vuloi05/he_nhung_remote/Core/Src/main.c

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
/* Includes ------------------------------------------------------------------*/
#include "main.h"
#include "cmsis_os.h"
#include "adc.h"
#include "crc.h"
#include "dma.h"
#include "dma2d.h"
#include "i2c.h"
#include "ltdc.h"
#include "spi.h"
#include "usb_device.h"
#include "gpio.h"
#include "fmc.h"
#include "app_touchgfx.h"

/* USER CODE BEGIN Includes */
#include "Components/ili9341/ili9341.h"
#include "input_manager.h"
/* USER CODE END Includes */

/* USER CODE BEGIN PD */
#define REFRESH_COUNT           ((uint32_t)1386)   /* SDRAM refresh counter */
#define SDRAM_TIMEOUT           ((uint32_t)0xFFFF)

/**
  * @brief  FMC SDRAM Mode definition register defines
  */
#define SDRAM_MODEREG_BURST_LENGTH_1             ((uint16_t)0x0000)
#define SDRAM_MODEREG_BURST_LENGTH_2             ((uint16_t)0x0001)
#define SDRAM_MODEREG_BURST_LENGTH_4             ((uint16_t)0x0002)
#define SDRAM_MODEREG_BURST_LENGTH_8             ((uint16_t)0x0004)
#define SDRAM_MODEREG_BURST_TYPE_SEQUENTIAL      ((uint16_t)0x0000)
#define SDRAM_MODEREG_BURST_TYPE_INTERLEAVED     ((uint16_t)0x0008)
#define SDRAM_MODEREG_CAS_LATENCY_2              ((uint16_t)0x0020)
#define SDRAM_MODEREG_CAS_LATENCY_3              ((uint16_t)0x0030)
#define SDRAM_MODEREG_OPERATING_MODE_STANDARD    ((uint16_t)0x0000)
#define SDRAM_MODEREG_WRITEBURST_MODE_PROGRAMMED ((uint16_t)0x0000)
#define SDRAM_MODEREG_WRITEBURST_MODE_SINGLE     ((uint16_t)0x0200)

#define I2C3_TIMEOUT_MAX                    0x3000 /*<! The value of the maximal timeout for I2C waiting loops */
#define SPI5_TIMEOUT_MAX                    0x1000
/* USER CODE END PD */


/* USER CODE BEGIN PV */
uint8_t isRevD = 0; /* Applicable only for STM32F429I DISCOVERY REVD and above */
/* USER CODE END PV */

void SystemClock_Config(void);
void MX_FREERTOS_Init(void);
/* USER CODE BEGIN PFP */
static void BSP_SDRAM_Initialization_Sequence(SDRAM_HandleTypeDef *hsdram, FMC_SDRAM_CommandTypeDef *Command);



static uint8_t            I2C3_ReadData(uint8_t Addr, uint8_t Reg);
static void               I2C3_WriteData(uint8_t Addr, uint8_t Reg, uint8_t Value);
static uint8_t            I2C3_ReadBuffer(uint8_t Addr, uint8_t Reg, uint8_t *pBuffer, uint16_t Length);

/* SPIx bus function */
static void               SPI5_Write(uint16_t Value);
static uint32_t           SPI5_Read(uint8_t ReadSize);
static void               SPI5_Error(void);

/* Link function for LCD peripheral */
void                      LCD_IO_Init(void);
void                      LCD_IO_WriteData(uint16_t RegValue);
void                      LCD_IO_WriteReg(uint8_t Reg);
uint32_t                  LCD_IO_ReadData(uint16_t RegValue, uint8_t ReadSize);
void                      LCD_Delay(uint32_t delay);

/* IOExpander IO functions */
void                      IOE_Init(void);
void                      IOE_ITConfig(void);
void                      IOE_Delay(uint32_t Delay);
void                      IOE_Write(uint8_t Addr, uint8_t Reg, uint8_t Value);
uint8_t                   IOE_Read(uint8_t Addr, uint8_t Reg);
uint16_t                  IOE_ReadMultiple(uint8_t Addr, uint8_t Reg, uint8_t *pBuffer, uint16_t Length);

/* USER CODE END PFP */

/* USER CODE BEGIN 0 */
static LCD_DrvTypeDef* LcdDrv;

uint32_t I2c3Timeout = I2C3_TIMEOUT_MAX; /*<! Value of Timeout when I2C communication fails */
uint32_t Spi5Timeout = SPI5_TIMEOUT_MAX; /*<! Value of Timeout when SPI communication fails */
/* USER CODE END 0 */

/**
  * @brief  The application entry point.
  * @retval int
  */
int main(void)
{

  /* MCU Configuration--------------------------------------------------------*/

  /* Reset of all peripherals, Initializes the Flash interface and the Systick. */
  HAL_Init();

  /* Configure the system clock */
  SystemClock_Config();

  /* Initialize all configured peripherals */
  MX_GPIO_Init();
  MX_DMA_Init();
  MX_CRC_Init();
  MX_I2C3_Init();
  MX_SPI5_Init();
  MX_FMC_Init();
  MX_LTDC_Init();
  MX_DMA2D_Init();
  MX_ADC1_Init();
  MX_ADC3_Init();
  MX_TouchGFX_Init();
  /* Call PreOsInit function */
  MX_TouchGFX_PreOSInit();
  /* USER CODE BEGIN 2 */
  // 1. Đánh thức và cấu hình chip màn hình ILI9341
  ili9341_Init();

  // 2. Gửi chuỗi lệnh kích hoạt RAM ngoài (SDRAM) để TouchGFX có chỗ vẽ UI
  FMC_SDRAM_CommandTypeDef command;
  BSP_SDRAM_Initialization_Sequence(&hsdram1, &command);

  /* USER CODE END 2 */

  /* Init scheduler */
  osKernelInitialize();  /* Call init function for freertos objects (in cmsis_os2.c) */
  MX_FREERTOS_Init();

  /* Start scheduler */
  osKernelStart();

  /* We should never get here as control is now taken by the scheduler */

  /* Infinite loop */
  /* USER CODE BEGIN WHILE */
  while (1)
  {
    /* USER CODE END WHILE */

    /* USER CODE BEGIN 3 */
  }
  /* USER CODE END 3 */
}

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
/* USER CODE BEGIN 4 */
/**
  * @brief  Perform the SDRAM external memory initialization sequence
  * @param  hsdram: SDRAM handle
  * @param  Command: Pointer to SDRAM command structure
  * @retval None
  */
static void BSP_SDRAM_Initialization_Sequence(SDRAM_HandleTypeDef *hsdram, FMC_SDRAM_CommandTypeDef *Command)
{
 __IO uint32_t tmpmrd =0;

  /* Step 1:  Configure a clock configuration enable command */
  Command->CommandMode             = FMC_SDRAM_CMD_CLK_ENABLE;
  Command->CommandTarget           = FMC_SDRAM_CMD_TARGET_BANK2;
  Command->AutoRefreshNumber       = 1;
  Command->ModeRegisterDefinition  = 0;

  /* Send the command */
  HAL_SDRAM_SendCommand(hsdram, Command, SDRAM_TIMEOUT);

  /* Step 2: Insert 100 us minimum delay */
  /* Inserted delay is equal to 1 ms due to systick time base unit (ms) */
  HAL_Delay(1);

  /* Step 3: Configure a PALL (precharge all) command */
  Command->CommandMode             = FMC_SDRAM_CMD_PALL;
  Command->CommandTarget           = FMC_SDRAM_CMD_TARGET_BANK2;
  Command->AutoRefreshNumber       = 1;
  Command->ModeRegisterDefinition  = 0;

  /* Send the command */
  HAL_SDRAM_SendCommand(hsdram, Command, SDRAM_TIMEOUT);

  /* Step 4: Configure an Auto Refresh command */
  Command->CommandMode             = FMC_SDRAM_CMD_AUTOREFRESH_MODE;
  Command->CommandTarget           = FMC_SDRAM_CMD_TARGET_BANK2;
  Command->AutoRefreshNumber       = 4;
  Command->ModeRegisterDefinition  = 0;

  /* Send the command */
  HAL_SDRAM_SendCommand(hsdram, Command, SDRAM_TIMEOUT);

  /* Step 5: Program the external memory mode register */
  tmpmrd = (uint32_t)SDRAM_MODEREG_BURST_LENGTH_1          |
                     SDRAM_MODEREG_BURST_TYPE_SEQUENTIAL   |
                     SDRAM_MODEREG_CAS_LATENCY_3           |
                     SDRAM_MODEREG_OPERATING_MODE_STANDARD |
                     SDRAM_MODEREG_WRITEBURST_MODE_SINGLE;

  Command->CommandMode             = FMC_SDRAM_CMD_LOAD_MODE;
  Command->CommandTarget           = FMC_SDRAM_CMD_TARGET_BANK2;
  Command->AutoRefreshNumber       = 1;
  Command->ModeRegisterDefinition  = tmpmrd;

  /* Send the command */
  HAL_SDRAM_SendCommand(hsdram, Command, SDRAM_TIMEOUT);

  /* Step 6: Set the refresh rate counter */
  /* Set the device refresh rate */
  HAL_SDRAM_ProgramRefreshRate(hsdram, REFRESH_COUNT);
}

/**
  * @brief  IOE Low Level Initialization.
  */
void IOE_Init(void)
{
  //Dummy function called when initializing to stmpe811 to setup the i2c.
  //This is done with cubmx and is therfore not done here.
}

/**
  * @brief  IOE Low Level Interrupt configuration.
  */
void IOE_ITConfig(void)
{
  //Dummy function called when initializing to stmpe811 to setup interupt for the i2c.
  //The interupt is not used in our case, therefore nothing is done here.
}

/**
  * @brief  IOE Writes single data operation.
  * @param  Addr: I2C Address
  * @param  Reg: Reg Address
  * @param  Value: Data to be written
  */
void IOE_Write(uint8_t Addr, uint8_t Reg, uint8_t Value)
{
  I2C3_WriteData(Addr, Reg, Value);
}

/**
  * @brief  IOE Reads single data.
  * @param  Addr: I2C Address
  * @param  Reg: Reg Address
  * @retval The read data
  */
uint8_t IOE_Read(uint8_t Addr, uint8_t Reg)
{
  return I2C3_ReadData(Addr, Reg);
}

/**
  * @brief  IOE Reads multiple data.
  * @param  Addr: I2C Address
  * @param  Reg: Reg Address
  * @param  pBuffer: pointer to data buffer
  * @param  Length: length of the data
  * @retval 0 if no problems to read multiple data
  */
uint16_t IOE_ReadMultiple(uint8_t Addr, uint8_t Reg, uint8_t *pBuffer, uint16_t Length)
{
 return I2C3_ReadBuffer(Addr, Reg, pBuffer, Length);
}

/**
  * @brief  IOE Delay.
  * @param  Delay in ms
  */
void IOE_Delay(uint32_t Delay)
{
  HAL_Delay(Delay);
}

/**
  * @brief  Writes a value in a register of the device through BUS.
  * @param  Addr: Device address on BUS Bus.
  * @param  Reg: The target register address to write
  * @param  Value: The target register value to be written
  */
static void I2C3_WriteData(uint8_t Addr, uint8_t Reg, uint8_t Value)
{
  HAL_StatusTypeDef status = HAL_OK;

  status = HAL_I2C_Mem_Write(&hi2c3, Addr, (uint16_t)Reg, I2C_MEMADD_SIZE_8BIT, &Value, 1, I2c3Timeout);

  /* Check the communication status */
  if(status != HAL_OK)
  {
    /* Re-Initialize the BUS */
    //I2Cx_Error();
  }
}

/**
  * @brief  Reads a register of the device through BUS.
  * @param  Addr: Device address on BUS Bus.
  * @param  Reg: The target register address to write
  * @retval Data read at register address
  */
static uint8_t I2C3_ReadData(uint8_t Addr, uint8_t Reg)
{
  HAL_StatusTypeDef status = HAL_OK;
  uint8_t value = 0;

  status = HAL_I2C_Mem_Read(&hi2c3, Addr, Reg, I2C_MEMADD_SIZE_8BIT, &value, 1, I2c3Timeout);

  /* Check the communication status */
  if(status != HAL_OK)
  {
    /* Re-Initialize the BUS */
    //I2Cx_Error();

  }
  return value;
}

/**
  * @brief  Reads multiple data on the BUS.
  * @param  Addr: I2C Address
  * @param  Reg: Reg Address
  * @param  pBuffer: pointer to read data buffer
  * @param  Length: length of the data
  * @retval 0 if no problems to read multiple data
  */
static uint8_t I2C3_ReadBuffer(uint8_t Addr, uint8_t Reg, uint8_t *pBuffer, uint16_t Length)
{
  HAL_StatusTypeDef status = HAL_OK;

  status = HAL_I2C_Mem_Read(&hi2c3, Addr, (uint16_t)Reg, I2C_MEMADD_SIZE_8BIT, pBuffer, Length, I2c3Timeout);

  /* Check the communication status */
  if(status == HAL_OK)
  {
    return 0;
  }
  else
  {
    /* Re-Initialize the BUS */
    //I2Cx_Error();

    return 1;
  }
}

/**
  * @brief  Reads 4 bytes from device.
  * @param  ReadSize: Number of bytes to read (max 4 bytes)
  * @retval Value read on the SPI
  */
static uint32_t SPI5_Read(uint8_t ReadSize)
{
  HAL_StatusTypeDef status = HAL_OK;
  uint32_t readvalue;

  status = HAL_SPI_Receive(&hspi5, (uint8_t*) &readvalue, ReadSize, Spi5Timeout);

  /* Check the communication status */
  if(status != HAL_OK)
  {
    /* Re-Initialize the BUS */
    SPI5_Error();
  }

  return readvalue;
}

/**
  * @brief  Writes a byte to device.
  * @param  Value: value to be written
  */
static void SPI5_Write(uint16_t Value)
{
  HAL_StatusTypeDef status = HAL_OK;

  status = HAL_SPI_Transmit(&hspi5, (uint8_t*) &Value, 1, Spi5Timeout);

  /* Check the communication status */
  if(status != HAL_OK)
  {
    /* Re-Initialize the BUS */
    SPI5_Error();
  }
}

/**
  * @brief  SPI5 error treatment function.
  */
static void SPI5_Error(void)
{
  /* De-initialize the SPI communication BUS */
  //HAL_SPI_DeInit(&SpiHandle);

  /* Re- Initialize the SPI communication BUS */
  //SPIx_Init();
}

void LCD_IO_Init(void)
{
  /* Set or Reset the control line */
  HAL_GPIO_WritePin(GPIOC, GPIO_PIN_2, GPIO_PIN_RESET);
  HAL_GPIO_WritePin(GPIOC, GPIO_PIN_2, GPIO_PIN_SET);
}

/**
  * @brief  Writes register value.
  */
void LCD_IO_WriteData(uint16_t RegValue)
{
  /* Set WRX to send data */
  HAL_GPIO_WritePin(GPIOD, GPIO_PIN_13, GPIO_PIN_SET);

  /* Reset LCD control line(/CS) and Send data */
  HAL_GPIO_WritePin(GPIOC, GPIO_PIN_2, GPIO_PIN_RESET);
  SPI5_Write(RegValue);

  /* Deselect: Chip Select high */
  HAL_GPIO_WritePin(GPIOC, GPIO_PIN_2, GPIO_PIN_SET);
}

/**
  * @brief  Writes register address.
  */
void LCD_IO_WriteReg(uint8_t Reg)
{
  /* Reset WRX to send command */
  HAL_GPIO_WritePin(GPIOD, GPIO_PIN_13, GPIO_PIN_RESET);

  /* Reset LCD control line(/CS) and Send command */
  HAL_GPIO_WritePin(GPIOC, GPIO_PIN_2, GPIO_PIN_RESET);
  SPI5_Write(Reg);

  /* Deselect: Chip Select high */
  HAL_GPIO_WritePin(GPIOC, GPIO_PIN_2, GPIO_PIN_SET);
}

/**
  * @brief  Reads register value.
  * @param  RegValue Address of the register to read
  * @param  ReadSize Number of bytes to read
  * @retval Content of the register value
  */
uint32_t LCD_IO_ReadData(uint16_t RegValue, uint8_t ReadSize)
{
  uint32_t readvalue = 0;

  /* Select: Chip Select low */
  HAL_GPIO_WritePin(GPIOC, GPIO_PIN_2, GPIO_PIN_RESET);

  /* Reset WRX to send command */
  HAL_GPIO_WritePin(GPIOD, GPIO_PIN_13, GPIO_PIN_RESET);

  SPI5_Write(RegValue);

  readvalue = SPI5_Read(ReadSize);

  /* Set WRX to send data */
  HAL_GPIO_WritePin(GPIOD, GPIO_PIN_13, GPIO_PIN_SET);

  /* Deselect: Chip Select high */
  HAL_GPIO_WritePin(GPIOC, GPIO_PIN_2, GPIO_PIN_SET);

  return readvalue;
}

/**
  * @brief  Wait for loop in ms.
  * @param  Delay in ms.
  */
void LCD_Delay(uint32_t Delay)
{
  HAL_Delay(Delay);
}

void HAL_GPIO_EXTI_Callback(uint16_t GPIO_Pin)
{
    // Kích hoạt khi nhấn nút USER (Nối PA0)
    if(GPIO_Pin == USER_BTN_Pin)
    {
        // Kỹ thuật Debounce (Chống dội phím) đơn giản
        // Nếu nhấn quá sát nhau (dưới 200ms) thì bỏ qua
        static uint32_t last_time = 0;
        uint32_t current_time = HAL_GetTick();

        if (current_time - last_time > 200) {
            InputManager_ToggleMode();
            last_time = current_time;
        }
    }
}

/* USER CODE END 4 */

/**
  * @brief  Period elapsed callback in non blocking mode
  * @note   This function is called  when TIM6 interrupt took place, inside
  * HAL_TIM_IRQHandler(). It makes a direct call to HAL_IncTick() to increment
  * a global variable "uwTick" used as application time base.
  * @param  htim : TIM handle
  * @retval None
  */
void HAL_TIM_PeriodElapsedCallback(TIM_HandleTypeDef *htim)
{
  if (htim->Instance == TIM6)
  {
    HAL_IncTick();
  }
}

/**
  * @brief  This function is executed in case of error occurrence.
  * @retval None
  */
void Error_Handler(void)
{
  /* USER CODE BEGIN Error_Handler_Debug */
  /* User can add his own implementation to report the HAL error return state */

  /* USER CODE END Error_Handler_Debug */
}
#ifdef USE_FULL_ASSERT
/**
  * @brief  Reports the name of the source file and the source line number
  *         where the assert_param error has occurred.
  * @param  file: pointer to the source file name
  * @param  line: assert_param error line source number
  * @retval None
  */
void assert_failed(uint8_t *file, uint32_t line)
{
  /* USER CODE BEGIN 6 */
  /* User can add his own implementation to report the file name and line number,
     tex: printf("Wrong parameters value: file %s on line %d\r\n", file, line) */
  /* USER CODE END 6 */
}
#endif /* USE_FULL_ASSERT */
