vuloi05/he_nhung_remote/Core/Inc/main.h

#define VSYNC_FREQ_Pin GPIO_PIN_2
#define VSYNC_FREQ_GPIO_Port GPIOE
#define RENDER_TIME_Pin GPIO_PIN_3
#define RENDER_TIME_GPIO_Port GPIOE
#define FRAME_RATE_Pin GPIO_PIN_4
#define FRAME_RATE_GPIO_Port GPIOE
#define MCU_ACTIVE_Pin GPIO_PIN_5
#define MCU_ACTIVE_GPIO_Port GPIOE
#define SPI5_NCS_Pin GPIO_PIN_1
#define SPI5_NCS_GPIO_Port GPIOC
#define USER_BTN_Pin GPIO_PIN_0
#define USER_BTN_GPIO_Port GPIOA
#define USER_BTN_EXTI_IRQn EXTI0_IRQn
#define JOY_L_SW_Pin GPIO_PIN_2
#define JOY_L_SW_GPIO_Port GPIOB
#define BTN_L2_Pin GPIO_PIN_2
#define BTN_L2_GPIO_Port GPIOG
#define BTN_R2_Pin GPIO_PIN_3
#define BTN_R2_GPIO_Port GPIOG
#define BTN_CROSS_Pin GPIO_PIN_8
#define BTN_CROSS_GPIO_Port GPIOC
#define BTN_CIRCLE_Pin GPIO_PIN_9
#define BTN_CIRCLE_GPIO_Port GPIOA
#define BTN_SQUARE_Pin GPIO_PIN_10
#define BTN_SQUARE_GPIO_Port GPIOA
#define BTN_R1_Pin GPIO_PIN_2
#define BTN_R1_GPIO_Port GPIOD
#define LED_GREEN_Pin GPIO_PIN_13
#define LED_GREEN_GPIO_Port GPIOG
#define LED_RED_Pin GPIO_PIN_14
#define LED_RED_GPIO_Port GPIOG
#define BTN_TRIANGLE_Pin GPIO_PIN_3
#define BTN_TRIANGLE_GPIO_Port GPIOB
#define JOY_R_SW_Pin GPIO_PIN_4
#define JOY_R_SW_GPIO_Port GPIOB
#define BTN_L1_Pin GPIO_PIN_7
#define BTN_L1_GPIO_Port GPIOB
