vuloi05/he_nhung_remote/Core/Src/L3GD20.c

//----------------------------------------------------------------------------//
// This file is from https://github.com/adem-alnajjar/Gyroscope-L3GD20-_STM32 //
// and was modified by Cong Thuan Do (HUST) for STM32F429-DISC1 board         //
//----------------------------------------------------------------------------//

#include "main.h"
#include "L3GD20.h"

#define AVERAGE_WINDOW_SIZE                  ((uint32_t) 10u)
#define CALIBRATION_BUFFER_LENGTH            ((uint32_t) 2000u)
#define L3GD20_SENSITIVITY    ((float)0.07)
#define GYRO_LEAK_FACTOR 0.999f // 100Hz -> mất 50% tín hiệu sau 1.38s

extern SPI_HandleTypeDef hspi5;

typedef enum
{
	L3GD20_DATA_NOT_READY,
	L3GD20_DATA_READY,
}L3GD20_DataReadyFlagType;

static L3GD20_DataReadyFlagType dataReadyFlag=L3GD20_DATA_READY;

typedef enum
{
	L3GD20_collect_calibration_samples,
	L3GD20_process_calibration_samples,
	L3GD20_calibrated,
}L3GD20_caliStateType;

static L3GD20_caliStateType currentcalistate=L3GD20_collect_calibration_samples;



typedef enum
{
	L3GD20_fisrt,
	L3GD20_second,
	L3GD20_finaly
}L3GD20_StateType;
static L3GD20_StateType currentState=L3GD20_fisrt;
	

static float angleRate_x=0;
static float angleRate_y=0;
static float angleRate_z=0;

static int32_t offset_x=0;
static int32_t offset_y=0;
static int32_t offset_z=0;

static float Noise_X = 0;
static float Noise_Y = 0;
static float Noise_Z = 0;

static float Angle_X = 0;
static float Angle_Y = 0;
static float Angle_Z = 0;

static float LastAngleRate_X = 0;
static float LastAngleRate_Y = 0;
static float LastAngleRate_Z = 0;

static int32_t TempNoise_X = 0;
static int32_t TempNoise_Y = 0;
static int32_t TempNoise_Z = 0;


volatile static uint32_t caliCounter = 0;


static int16_t calibrationBuffer_X[CALIBRATION_BUFFER_LENGTH];
static int16_t calibrationBuffer_Y[CALIBRATION_BUFFER_LENGTH];
static int16_t calibrationBuffer_Z[CALIBRATION_BUFFER_LENGTH];

static uint8_t spiTxBuf[2];
static uint8_t spiRxBuf[7];

void L3GD20_Init(void)
{
	HAL_GPIO_WritePin(GPIOC,GPIO_PIN_1,GPIO_PIN_SET);
	HAL_Delay(20);
	
	HAL_GPIO_WritePin(GPIOC,GPIO_PIN_1,GPIO_PIN_RESET);
	HAL_Delay(20);
	spiTxBuf[0]=0x20;
	spiTxBuf[1]=0xff;
	HAL_SPI_Transmit(&hspi5,spiTxBuf,2,50);
	HAL_GPIO_WritePin(GPIOC,GPIO_PIN_1,GPIO_PIN_SET);
	HAL_Delay(20);
	
	HAL_GPIO_WritePin(GPIOC,GPIO_PIN_1,GPIO_PIN_RESET);
	HAL_Delay(20);
	spiTxBuf[0]=0x21;
	spiTxBuf[1]=0x00;
	HAL_SPI_Transmit(&hspi5,spiTxBuf,2,50);
	HAL_GPIO_WritePin(GPIOC,GPIO_PIN_1,GPIO_PIN_SET);
	HAL_Delay(20);
	
	HAL_GPIO_WritePin(GPIOC,GPIO_PIN_1,GPIO_PIN_RESET);
	HAL_Delay(20);
	spiTxBuf[0]=0x22;
	spiTxBuf[1]=0x00;
	HAL_SPI_Transmit(&hspi5,spiTxBuf,2,50);
	HAL_GPIO_WritePin(GPIOC,GPIO_PIN_1,GPIO_PIN_SET);
	HAL_Delay(20);
	
	HAL_GPIO_WritePin(GPIOC,GPIO_PIN_1,GPIO_PIN_RESET);
	HAL_Delay(20);
	spiTxBuf[0]=0x23;
	spiTxBuf[1]=0x20;
	HAL_SPI_Transmit(&hspi5,spiTxBuf,2,50);
	HAL_GPIO_WritePin(GPIOC,GPIO_PIN_1,GPIO_PIN_SET);
	HAL_Delay(20);
	
	HAL_GPIO_WritePin(GPIOC,GPIO_PIN_1,GPIO_PIN_RESET);
	HAL_Delay(20);
	spiTxBuf[0]=0x24;
	spiTxBuf[1]=0x10;
	HAL_SPI_Transmit(&hspi5,spiTxBuf,2,50);
	HAL_GPIO_WritePin(GPIOC,GPIO_PIN_1,GPIO_PIN_SET);
	HAL_Delay(20);
	
}

void L3GD20_loop(void)
{
		volatile int16_t Raw_x=0;
		volatile int16_t Raw_y=0;
		volatile int16_t Raw_z=0;

		float difftime=0;
		
		int16_t averageWindow_X[AVERAGE_WINDOW_SIZE] = {0};
		int16_t averageWindow_Y[AVERAGE_WINDOW_SIZE] = {0};
		int16_t averageWindow_Z[AVERAGE_WINDOW_SIZE] = {0};
		
		uint32_t windowPosition = 0;
		int32_t tempSum_X = 0;
		int32_t tempSum_Y = 0;
		int32_t tempSum_Z = 0;
		
		//DCT
		//Angle_X = 0;
		//Angle_Y = 0;
		//Angle_Z = 0;

		switch(currentState)
		{
			//---------------------------------------------------------------------------
			//data 
			case(L3GD20_fisrt):
				if(dataReadyFlag==L3GD20_DATA_READY)
				{
					HAL_GPIO_WritePin(GPIOC,GPIO_PIN_1,GPIO_PIN_RESET);
						spiTxBuf[0]=0x28|0x80;
						HAL_SPI_Transmit(&hspi5,spiTxBuf,1,50);
						HAL_SPI_Receive(&hspi5,&spiRxBuf[1],1,50);
						HAL_GPIO_WritePin(GPIOC,GPIO_PIN_1,GPIO_PIN_SET);
							
						HAL_GPIO_WritePin(GPIOC,GPIO_PIN_1,GPIO_PIN_RESET);
						spiTxBuf[0]=0x29|0x80;
						HAL_SPI_Transmit(&hspi5,spiTxBuf,1,50);
						HAL_SPI_Receive(&hspi5,&spiRxBuf[2],1,50);
						HAL_GPIO_WritePin(GPIOC,GPIO_PIN_1,GPIO_PIN_SET);
							
						HAL_GPIO_WritePin(GPIOC,GPIO_PIN_1,GPIO_PIN_RESET);
						spiTxBuf[0]=0x2a|0x80;
						HAL_SPI_Transmit(&hspi5,spiTxBuf,1,50);
						HAL_SPI_Receive(&hspi5,&spiRxBuf[3],1,50);
						HAL_GPIO_WritePin(GPIOC,GPIO_PIN_1,GPIO_PIN_SET);
							
						HAL_GPIO_WritePin(GPIOC,GPIO_PIN_1,GPIO_PIN_RESET);
						spiTxBuf[0]=0x2b|0x80;
						HAL_SPI_Transmit(&hspi5,spiTxBuf,1,50);
						HAL_SPI_Receive(&hspi5,&spiRxBuf[4],1,50);
						HAL_GPIO_WritePin(GPIOC,GPIO_PIN_1,GPIO_PIN_SET);
						
						HAL_GPIO_WritePin(GPIOC,GPIO_PIN_1,GPIO_PIN_RESET);
						spiTxBuf[0]=0x2c|0x80;
						HAL_SPI_Transmit(&hspi5,spiTxBuf,1,50);
						HAL_SPI_Receive(&hspi5,&spiRxBuf[5],1,50);
						HAL_GPIO_WritePin(GPIOC,GPIO_PIN_1,GPIO_PIN_SET);
						
						HAL_GPIO_WritePin(GPIOC,GPIO_PIN_1,GPIO_PIN_RESET);
						spiTxBuf[0]=0x2d|0x80;
						HAL_SPI_Transmit(&hspi5,spiTxBuf,1,50);
						HAL_SPI_Receive(&hspi5,&spiRxBuf[6],1,50);
						HAL_GPIO_WritePin(GPIOC,GPIO_PIN_1,GPIO_PIN_SET);
						
						currentState=L3GD20_second;
						dataReadyFlag=L3GD20_DATA_NOT_READY;
				}
				else
				{
				}
						
				break;
						//-----------------------------------------------------------------------------------
						//varibla
			case(L3GD20_second):
				Raw_x=(spiRxBuf[2]<<8)|spiRxBuf[1];
				Raw_y=(spiRxBuf[4]<<8)|spiRxBuf[3];
				Raw_z=(spiRxBuf[6]<<8)|spiRxBuf[5];
			
			if(currentcalistate==L3GD20_calibrated)
			{
				angleRate_x=(float) (Raw_x - (offset_x))*L3GD20_SENSITIVITY;
				angleRate_y=(float) (Raw_y - (offset_y))*L3GD20_SENSITIVITY;
				angleRate_z=(float) (Raw_z - (offset_z))*L3GD20_SENSITIVITY;
				difftime=0.010f;

                if((angleRate_x>Noise_X)||(angleRate_x<-Noise_X))
                {
                    Angle_X+=((angleRate_x+LastAngleRate_X)*difftime)/(2.0f);
                    LastAngleRate_X=angleRate_x;
                }
                else
                {
                    // NẾU VẬN TỐC = 0, ÉP GÓC X TỪ TỪ XẢ VỀ 0
                    Angle_X *= GYRO_LEAK_FACTOR;
                }

                if((angleRate_y>Noise_Y)||(angleRate_y<-Noise_Y))
                {
                    Angle_Y+=((angleRate_y+LastAngleRate_Y)*difftime)/(2.0f);
                    LastAngleRate_Y=angleRate_y;
                }
                else
                {
                    // NẾU VẬN TỐC = 0, ÉP GÓC Y TỪ TỪ XẢ VỀ 0
                    Angle_Y *= GYRO_LEAK_FACTOR;
                }

				if((angleRate_z>Noise_Z)||(angleRate_z<-Noise_Z))
				{
					Angle_Z+=((angleRate_z+LastAngleRate_Z)*difftime)/(2.0f);
					LastAngleRate_Z=angleRate_z;
				}
				else
				{
				}
			}
			else
			{
				switch(currentcalistate)
				{
					//---------------------------------------------------------------------------------------------------------
					case(L3GD20_collect_calibration_samples):
						calibrationBuffer_X[caliCounter]=Raw_x;
						calibrationBuffer_Y[caliCounter]=Raw_y;
						calibrationBuffer_Z[caliCounter]=Raw_z;
						caliCounter++;
					
						if(caliCounter>=CALIBRATION_BUFFER_LENGTH)
						{
							caliCounter=0;
							
							currentcalistate=L3GD20_process_calibration_samples;
						}
						else
						{
						}
						break;
					//----------------------------------------------------------------------------------------------------------	
					case(L3GD20_process_calibration_samples):
						for(uint32_t idx=0; idx<CALIBRATION_BUFFER_LENGTH;idx++)
							{
								tempSum_X=tempSum_X-averageWindow_X[windowPosition]+calibrationBuffer_X[idx];
								tempSum_Y=tempSum_Y-averageWindow_Y[windowPosition]+calibrationBuffer_Y[idx];
								tempSum_Z=tempSum_Z-averageWindow_Z[windowPosition]+calibrationBuffer_Z[idx];
								
								averageWindow_X[windowPosition]=calibrationBuffer_X[idx];
								averageWindow_Y[windowPosition]=calibrationBuffer_Y[idx];
								averageWindow_Z[windowPosition]=calibrationBuffer_Z[idx];
								
								offset_x=tempSum_X/(int32_t)AVERAGE_WINDOW_SIZE;
								offset_y=tempSum_Y/(int32_t)AVERAGE_WINDOW_SIZE;
								offset_z=tempSum_Z/(int32_t)AVERAGE_WINDOW_SIZE;
								
								windowPosition++;
								
								if(windowPosition>=AVERAGE_WINDOW_SIZE)
								{
									windowPosition=0;
								}
								else
								{
								}
								
							}
							for(uint32_t idx=0;idx<CALIBRATION_BUFFER_LENGTH;idx++)
							{
								if(((int32_t)calibrationBuffer_X[idx]-offset_x)>TempNoise_X)
								{
									TempNoise_X=(int32_t)calibrationBuffer_X[idx]-offset_x;
								}
								else if(((int32_t)calibrationBuffer_X[idx]-offset_x)<-TempNoise_X)
								{
									TempNoise_X=-((int32_t)calibrationBuffer_X[idx]-offset_x);
								}
								
								if(((int32_t)calibrationBuffer_Y[idx]-offset_y)>TempNoise_Y)
								{
									TempNoise_Y=(int32_t)calibrationBuffer_Y[idx]-offset_y;
								}
								else if(((int32_t)calibrationBuffer_Y[idx]-offset_y)<-TempNoise_Y)
								{
									TempNoise_Y=-((int32_t)calibrationBuffer_Y[idx]-offset_y);
								}
								
								if(((int32_t)calibrationBuffer_Z[idx]-offset_z)>TempNoise_Z)
								{
									TempNoise_Z=(int32_t)calibrationBuffer_Z[idx]-offset_z;
								}
								else if(((int32_t)calibrationBuffer_Z[idx]-offset_z)<-TempNoise_Z)
								{
									TempNoise_Z=-((int32_t)calibrationBuffer_Z[idx]-offset_z);
								}
							}
							
							Noise_X=(float)TempNoise_X*L3GD20_SENSITIVITY;
							Noise_Y=(float)TempNoise_Y*L3GD20_SENSITIVITY;
							Noise_Z=(float)TempNoise_Z*L3GD20_SENSITIVITY;
							
							currentcalistate=L3GD20_calibrated;
							break;
							
					case(L3GD20_calibrated):
						break;
					
					default:
						break;
				}
						
			}
			currentState=L3GD20_fisrt;
			dataReadyFlag=L3GD20_DATA_READY;
			break;
			
					default:
						break;
			
		}
}

void L3GD20_ResetAngles(void)
{
    Angle_X = 0;
    Angle_Y = 0;
    Angle_Z = 0;
    LastAngleRate_X = 0;
    LastAngleRate_Y = 0;
    LastAngleRate_Z = 0;
}

float get_Angle_X(void)
{
	return Angle_X;
}
float get_Angle_Y(void)
{
	return Angle_Y;
}
float get_Angle_Z(void)
{
	return Angle_Z;
}

	
