vuloi05/he_nhung_remote/(commit log)

2026-07-03 Bật USB_OTG_HS (Kết nối Gamepad tới PC)
2026-07-03 Cấu hình ADC1 (Đọc Joystick Analog)
2026-07-03 Cấu hình GPIO Input cho Buttons + Joystick SW
2026-07-03 Cấu hình PA0 - Nút USER chuyển Mode
2026-07-03 Cấu hình LED chỉ thị Mode
2026-07-03 Thêm FreeRTOS Task: Input_Task để đọc joystick + buttons + gyro trong một task riêng
2026-07-03 Copy thư viện L3GD20 vào Project
2026-07-13 Update buttons field to support more buttons
    Changed buttons from uint8_t to uint16_t to support up to 16 buttons.
2026-07-13 Change button configuration from 8 to 16 buttons
2026-07-13 Add input manager for gamepad and ADC integration
    Implement input manager for gamepad handling and ADC processing.
2026-07-13 Add InputTask_Entry for ADC and GPIO management
    Implement InputTask_Entry function for handling ADC and GPIO.
2026-07-13 Add L3GD20_ResetAngles function to reset angles
    [L3GD20.c]
2026-07-13 Enhance input manager with gyroscope mode
    Added support for gyroscope input mode and a toggle function.
2026-07-13 Initialize gyroscope and implement mode toggle
    Added gyroscope initialization and mode toggling functionality.
2026-07-13 Implement button press handling with debounce
    Added input manager and implemented GPIO callback for button press with debounce logic.
2026-07-13 Refactor gyro input handling for joystick mapping
    Updated gyro sensitivity scaling and changed angle calculations for joystick mapping.
2026-07-13 Add gyro leak factor for angle calculations
    [L3GD20.c]
2026-07-13 Implement deadzone for angle inputs in input_manager
    Added deadzone checks for angle inputs to prevent jitter.
    [input_manager.c]
2026-07-15 hoàn thiện
