vuloi05/he_nhung_remote/(notices)

Notices in the files:
Core/Inc/main.h:
© Copyright (c) 2020 STMicroelectronics.
All rights reserved.
This software component is licensed by ST under Ultimate Liberty license
Core/Src/adc.c:
Copyright (c) 2026 STMicroelectronics.
This software is licensed under terms that can be found in the LICENSE file
